erufes/fusca-azul/modelo3d/Adaptador_roda_v5.stl

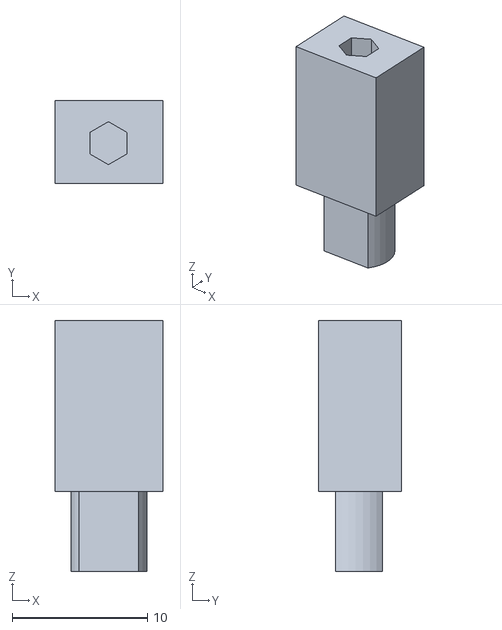
[picture p1: CAD file, 2026-05-21, last stored version]
modelo3d/Adaptador_roda_v5.stl
8.02 x 6.15 x 18.6
