erufes/fusca-azul/pcb/fusca-azul-pcb.stl

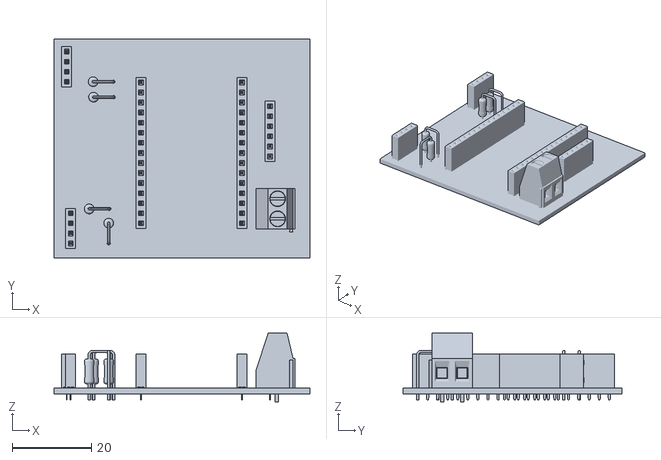
[picture p2: CAD file, 2026-05-21, last stored version]
pcb/fusca-azul-pcb.stl
64.6 x 55.3 x 17.3
