erufes/fusca-azul/modelo3d/base.stl

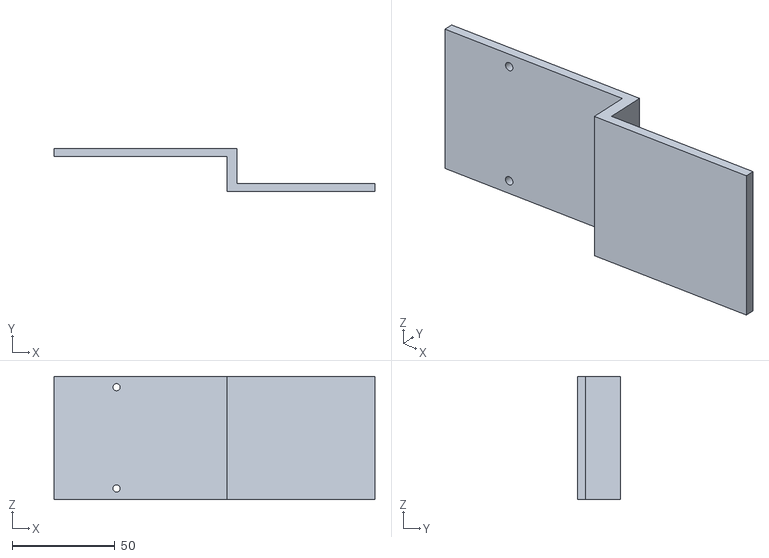
[picture p3: CAD file, 2026-05-21, last stored version]
modelo3d/base.stl
156.0 x 21.0 x 60.0
