erufes/fusca-azul/modelo3d/adaptador_roda_v4.stl

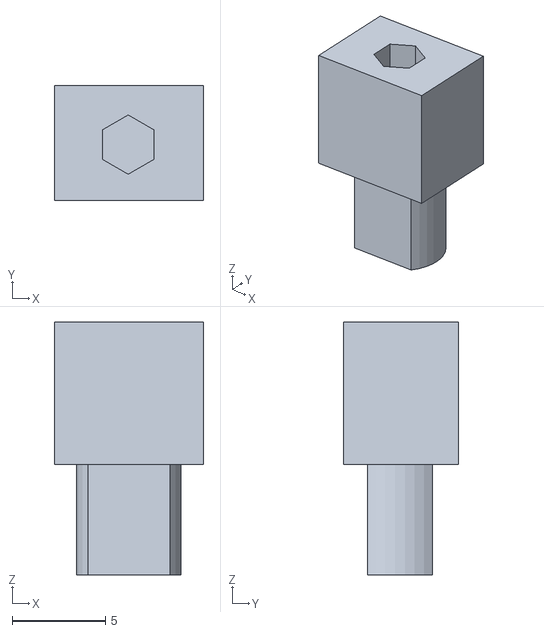
[picture p4: CAD file, 2026-05-11, an earlier design]
modelo3d/adaptador_roda_v4.stl
8.02 x 6.15 x 13.6
