erufes/fusca-azul/(list of files, cad)

Other CAD files:
modelo3d/Roda.f3d
