erufes/fusca-azul/pcb/fusca-azul.kicad_pcb

## KiCad design pcb/fusca-azul.kicad_pcb (2026-05-21, last stored version)

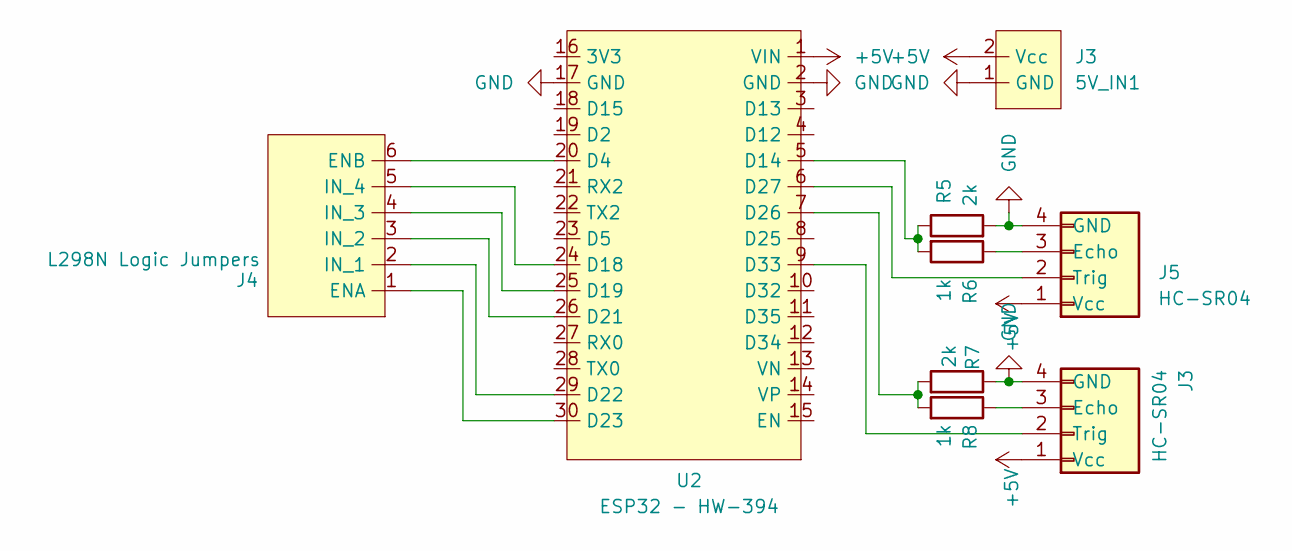
[picture p5: schematic fusca-azul.kicad_sch]

Parts:
5V_IN1: J3; TerminalBlock_Phoenix_MKDS-1,5-2-5.08_1x02_P5.08mm_Horizont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
J3, J5: HC-SR04; PinSocket_1x04_P2.54mm_Vertical
J4: L298N Logic Jumpers; PinSocket_1x06_P2.54mm_Vertical
R5, R7: 2k; R_Axial_DIN0207_L6.3mm_D2.5mm_P5.08mm_Vertical
R6, R8: 1k; R_Axial_DIN0207_L6.3mm_D2.5mm_P5.08mm_Vertical
U2: ESP32 - HW-394; ESP32-HW-394

Connections:
+5V: 5V_IN1.2 (Vcc), J3.1 (Vcc), J5.1 (Vcc), U2.1 (VIN)
GND: 5V_IN1.1 (GND), J3.4 (GND), J5.4 (GND), R5.2, R7.1, U2.2 (GND), U2.17 (GND)
unnamed: J3.3 (Echo), R8.1
unnamed: J3.2 (Trig), U2.9 (D33)
unnamed: J4.1 (ENA), U2.30 (D23)
unnamed: J4.6 (ENB), U2.20 (D4)
unnamed: J4.2 (IN_1), U2.29 (D22)
unnamed: J4.3 (IN_2), U2.26 (D21)
unnamed: J4.4 (IN_3), U2.25 (D19)
unnamed: J4.5 (IN_4), U2.24 (D18)
unnamed: J5.3 (Echo), R6.1
unnamed: J5.2 (Trig), U2.6 (D27)
unnamed: R5.1, R6.2, U2.5 (D14)
unnamed: R7.2, R8.2, U2.7 (D26)

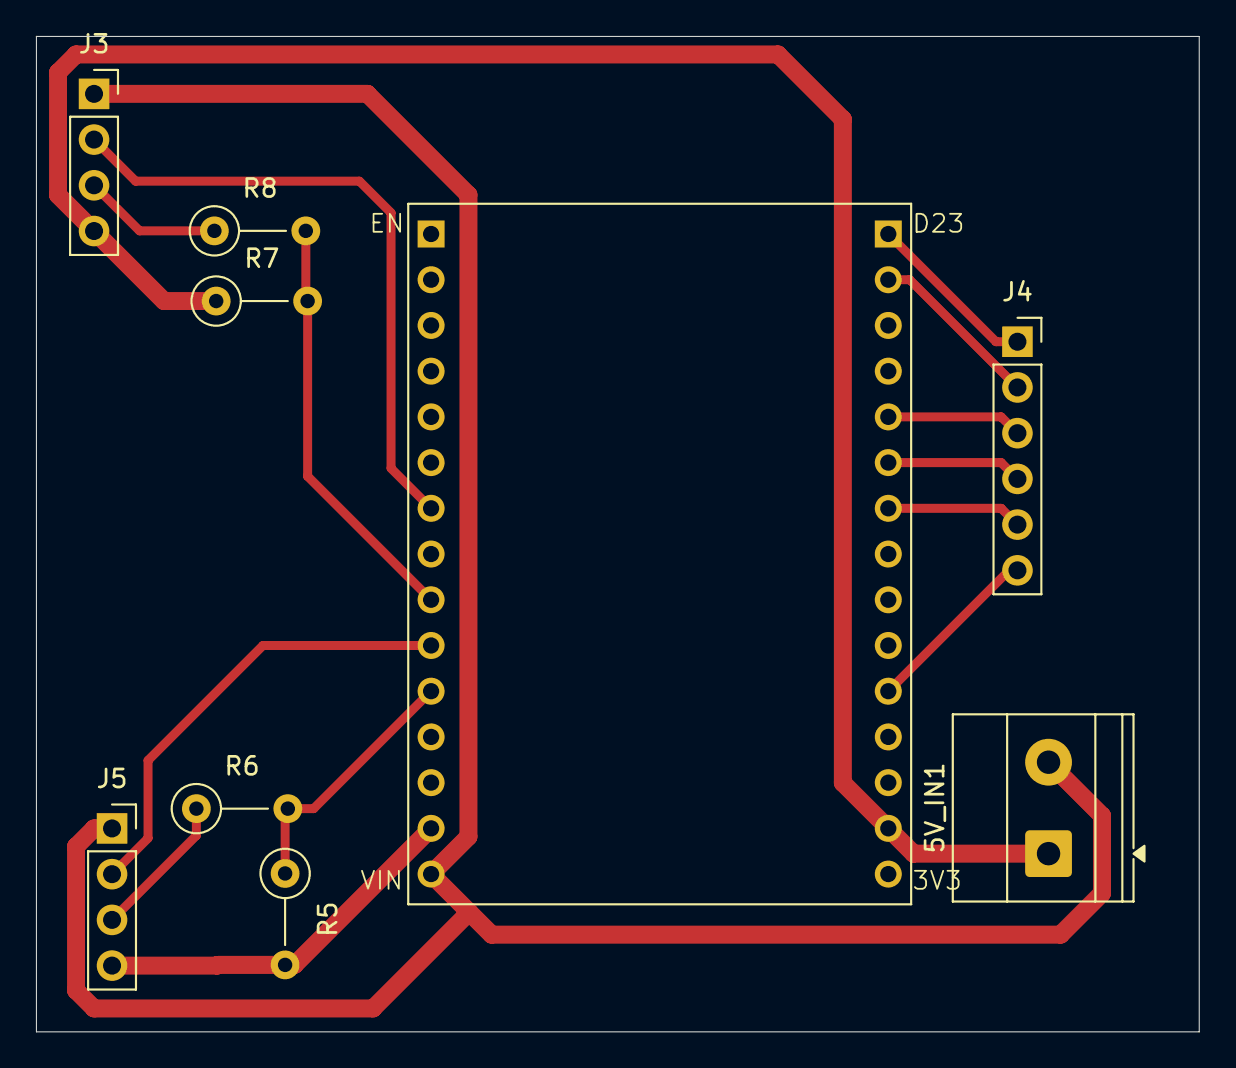
[picture p6: board fusca-azul.kicad_pcb from above]

Board: 2 copper layers, 64.6 x 55.3 mm, 9 parts (0 on the bottom side), 14 nets.
