erufes/fusca-azul/(commit log)

2026-04-29 Add initial project structure with .gitignore, README, and mocap module
    - Created .gitignore to exclude common Python artifacts and virtual environments.
    - Added README file for project documentation.
    - Introduced mocap module with hand gesture detection functionality, including:
    - `dedos.py`: Functions to determine finger positions.
    - `gestos.py`: Class to evaluate hand gestures based on finger positions.
    - `main.py`: Main application to capture video and detect hand gestures using MediaPipe.
    - Included hand_landmarker model file for gesture recognition.
2026-04-29 correção de possiveis erros e adicao de comentario
2026-04-30 correcao de comentarios
2026-04-30 Update de comentários
2026-04-30 adicionado codigo de teste do sensor ultrassonico
2026-04-30 correcao de nomes
2026-04-30 adicionado codigo para verificar as variaveis
2026-05-01 adiciona simbolos e schematic do projeto feito no kicad
    [fusca-azul.kicad_pcb, fusca-azul.kicad_sch]
2026-05-01 fix: corrige posicionamento errado dos resistores
    [fusca-azul.kicad_sch]
2026-05-03 feat: adiciona schematic para 3 sensores + separa schematics
    [fusca-azul-schematic.kicad_sch, fusca-azul-v1-1sensor.kicad_sch, fusca-azul-v2-3sensor.kicad_sch, fusca-azul.kicad_sch]
2026-05-03 feat: linka schematic a footprints
    [fusca-azul-v1-1sensor.kicad_sch, fusca-azul-v2-3sensor.kicad_sch]
2026-05-04 feat: começa a criar a pcb
    [fusca-azul-v1-1sensor.kicad_sch, fusca-azul-v2-3sensor.kicad_sch, fusca-azul.kicad_pcb]
2026-05-04 feat: add teste_wifi esp32
2026-05-04 Update robo.ino
    Atualizaçao do código do robo, adicionando alguns comentários e adição da variavel distanciaMaxima, com objetivo de deixar mais prático a mudança de tal valor
2026-05-04 Update robo.ino
    corrigido nome de algumas funções, adição das variaveis de ENA e ENB
2026-05-05 adicao de um codigo para implementar mais sensores
2026-05-05 adicao do codigo feito pra 2 sensores (esq e frent)
2026-05-08 transformando cod arduino pra esp32
2026-05-09 feat: atualiza a pcb, mas falta corrigir tamanho e organização
    [fusca-azul-v1-1sensor.kicad_sch, fusca-azul-v2-3sensor.kicad_sch, fusca-azul.kicad_pcb, fusca-azul.kicad_sch]
2026-05-10 feat: finaliza pcb
    [fusca-azul.kicad_pcb, fusca-azul.kicad_sch]
2026-05-10 fix: corrige ligacao na placa
    [fusca-azul.kicad_pcb, fusca-azul.kicad_sch]
2026-05-11 feat: adiciona objetos pra imprimir
    [adaptador_roda_v4.stl, base.stl]
2026-05-11 DESVIO DE OBSTACULOS FUNCIONANDO!!!
    alterei com intuito de corrigir a direção do robo, antes curvava levemente pra esquerda
2026-05-12 excluido codigo que foi usado apenas pra teste
2026-05-12 correcao de alguns argumentos
2026-05-12 adicao codigo de integracao
2026-05-13 add gesto, add deteccao de gesto no modo auto
2026-05-13 corrigido troca de modos
2026-05-13 adicionado delay na troca de modos
2026-05-13 delay da troca de modos aumentado
2026-05-13 adicionado codigo para 2 sensores ultrassonicos
2026-05-14 Instruções de Execução
2026-05-18 docs: move docs de lugar
2026-05-18 finaliza pcb
    [fusca-azul.kicad_pcb, fusca-azul.kicad_sch]
2026-05-20 Troca de IP
2026-05-21 corrige pcb com espaçamento erraado
    [fusca-azul-pcb.stl, fusca-azul.kicad_pcb]
2026-05-21 docs: adiciona documentação de hardware
    [fusca-azul-schematic.kicad_sch]
2026-05-21 atualiza 3Ds e adiciona modelo roda
    [Adaptador_roda_v5.stl, Roda.f3d, adaptador_roda_v4.stl, base.stl]
2026-05-21 docs: adiciona documentacao de estrutura
2026-05-21 docs: atualiza docs de hardware e readme
2026-08-30 refactor: movendo as coisas de lugar
    [Adaptador_roda_v5.stl, Roda.f3d, base.stl]
2026-09-21 feat: leitura sensor de distancia inicial
2026-09-21 feat: detecção de mao inicial
2026-09-21 feat: página com pontos de fixação na mão
2026-09-21 clean: remove informações legadas
    [Adaptador_roda_v5.stl, Roda.f3d, base.stl, fusca-azul-pcb.stl, fusca-azul.kicad_pcb, fusca-azul.kicad_sch]
2026-09-21 feat: adiciona aviso para caso tentar abrir câmera em contexto http
2026-09-22 feat: menu de config e tutorial
2026-09-23 feat: robô que anda
2026-09-24 fix: corrige câmera que nao funciona
2026-09-29 fix: corrige conexão dos motores
    [main.cpp]
2026-09-29 fix: corrige conexão wifi
    [GestosConnection.cpp, GestosConnection.h, Robot.cpp, Robot.h, StateLog.h, WifiConnection.cpp, WifiCredentials.cpp]
2026-09-29 feat: estabiliza rumo com GY-80 e ajusta reconhecimento de rock
2026-10-02 fix: remove GY-80, libera PWM máximo e adiciona parada por Esc
    [Motor.cpp, Motor.h, Robot.cpp, Robot.h, main.cpp]
2026-10-04 fix: desabilita troca de modo pelo gesto rock
2026-10-04 fix: aciona apenas o motor correspondente nas curvas
2026-10-06 Atualiza identidade visual e simplifica interface de gestos
